koko69420/UV-Curing-Box/Schematic.pdf

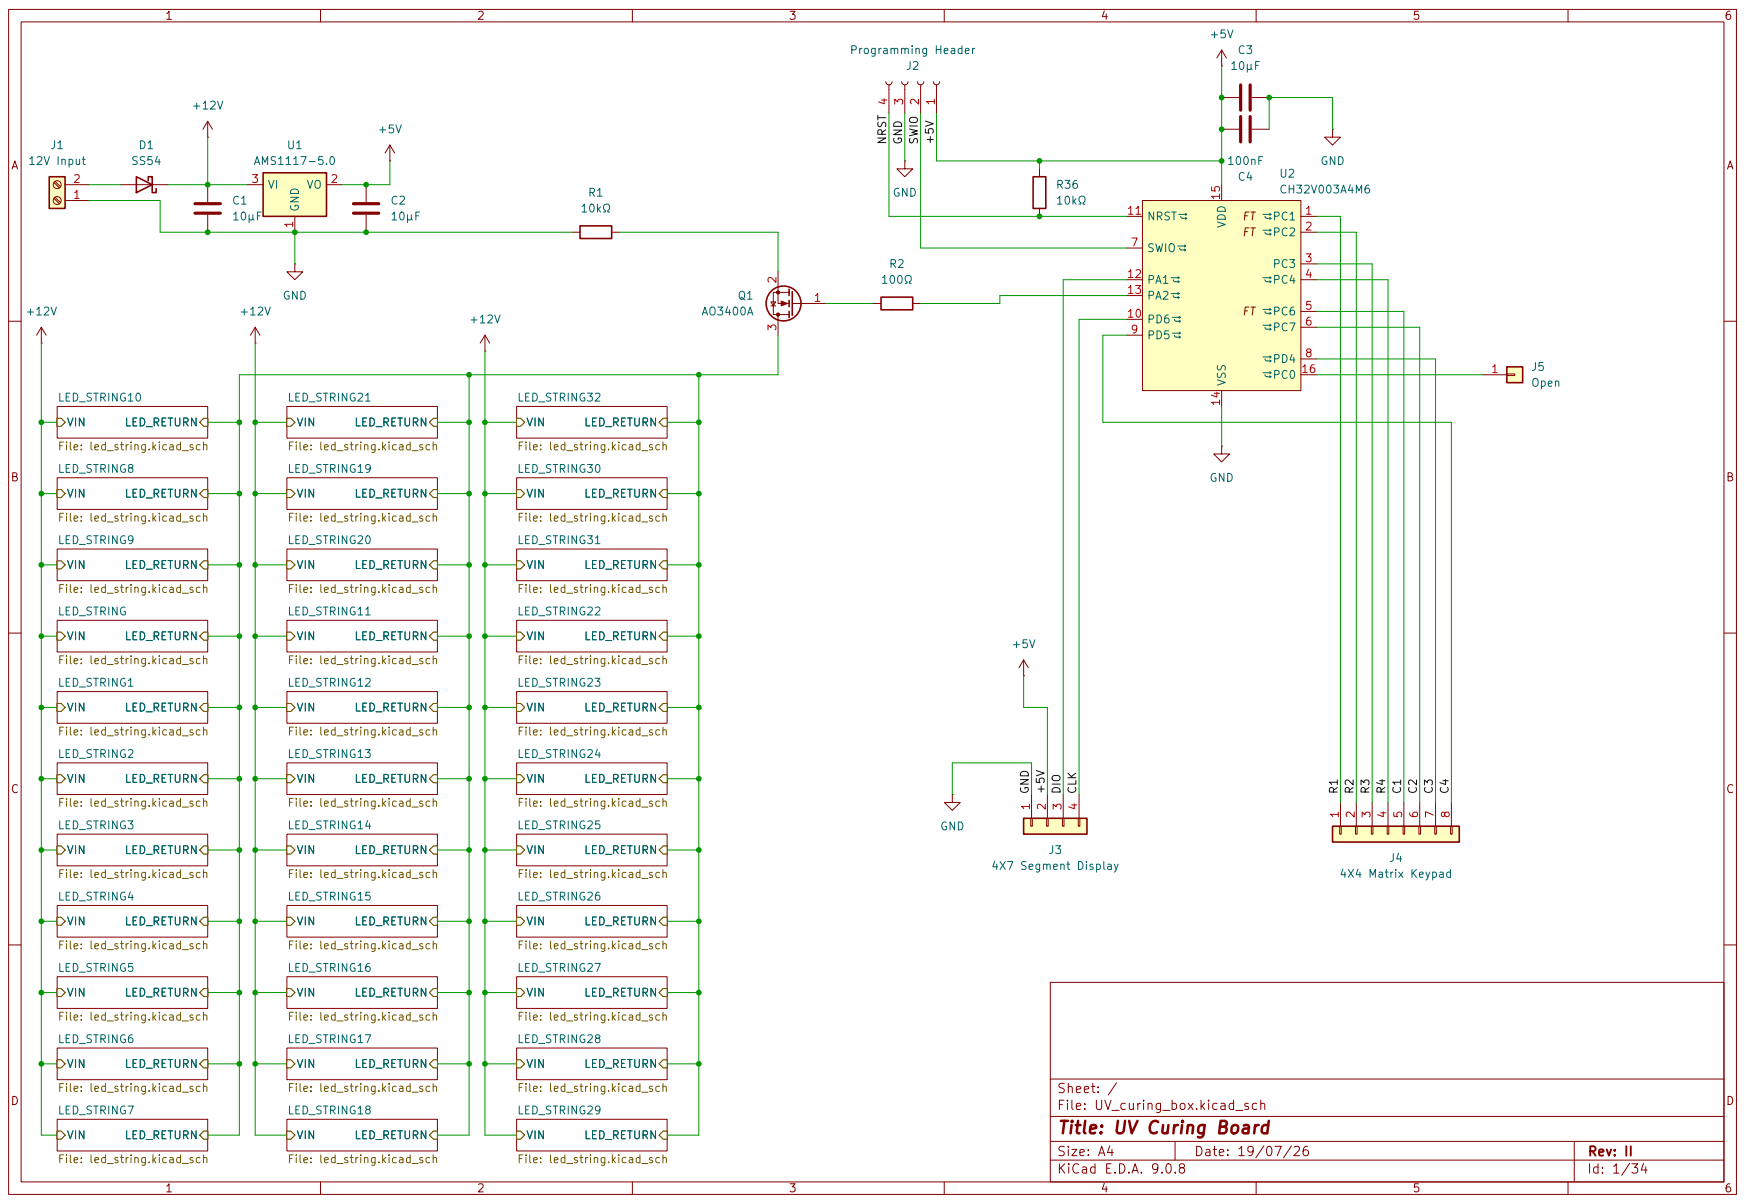
[picture p3: page 1]

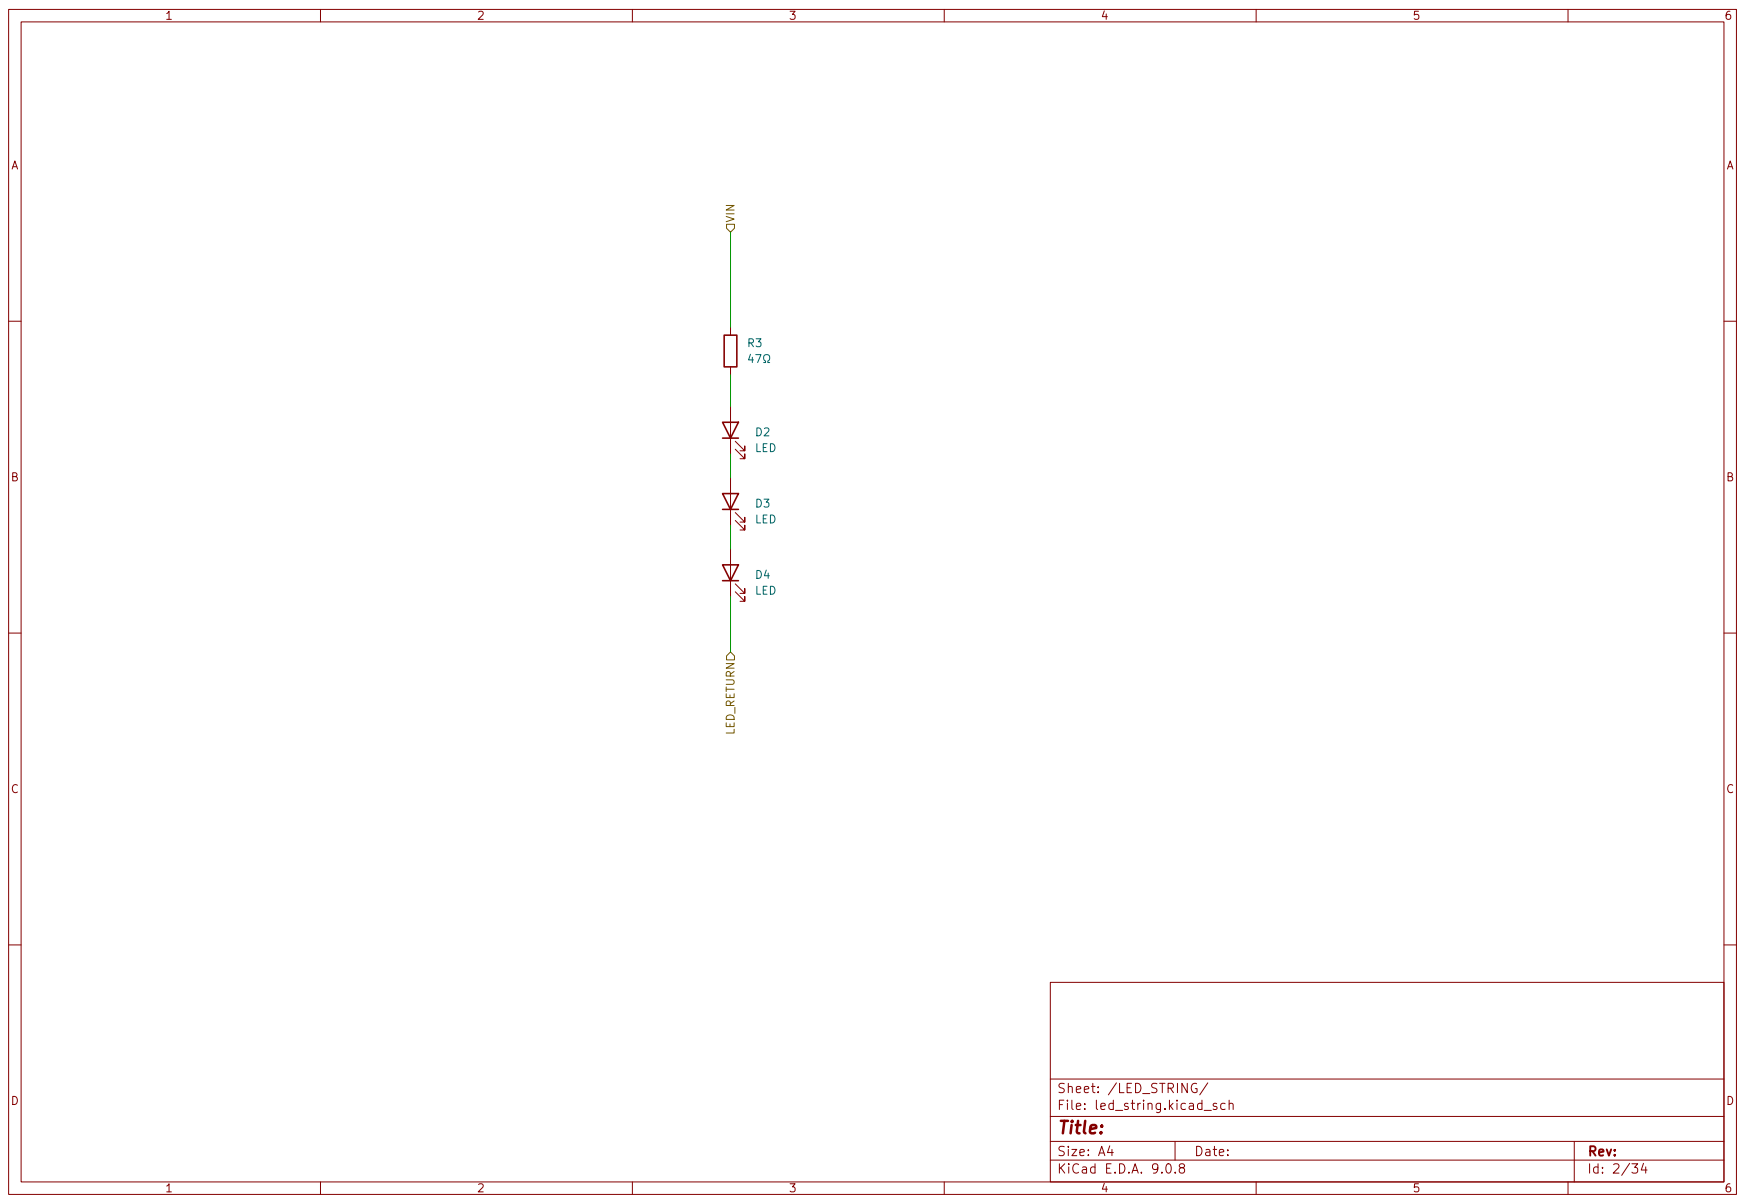
[picture p4: page 2]
