koko69420/UV-Curing-Box/UV_curing_box-B_Cu.pdf

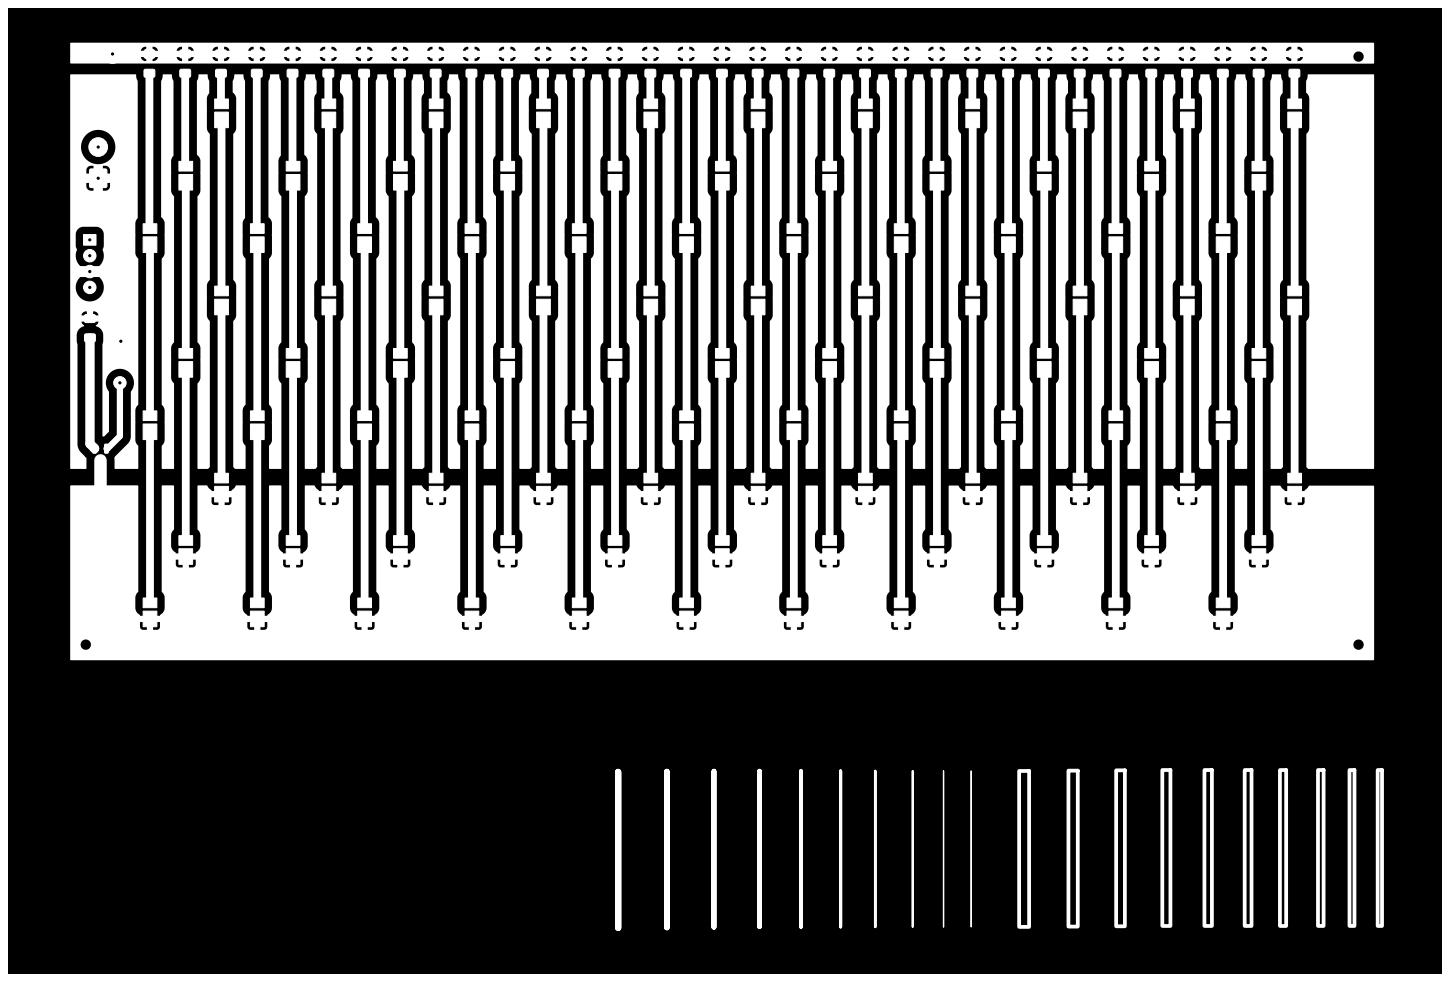
[picture p5: page 1]
