koko69420/UV-Curing-Box/UV_curing_box-Edge_Cuts.pdf

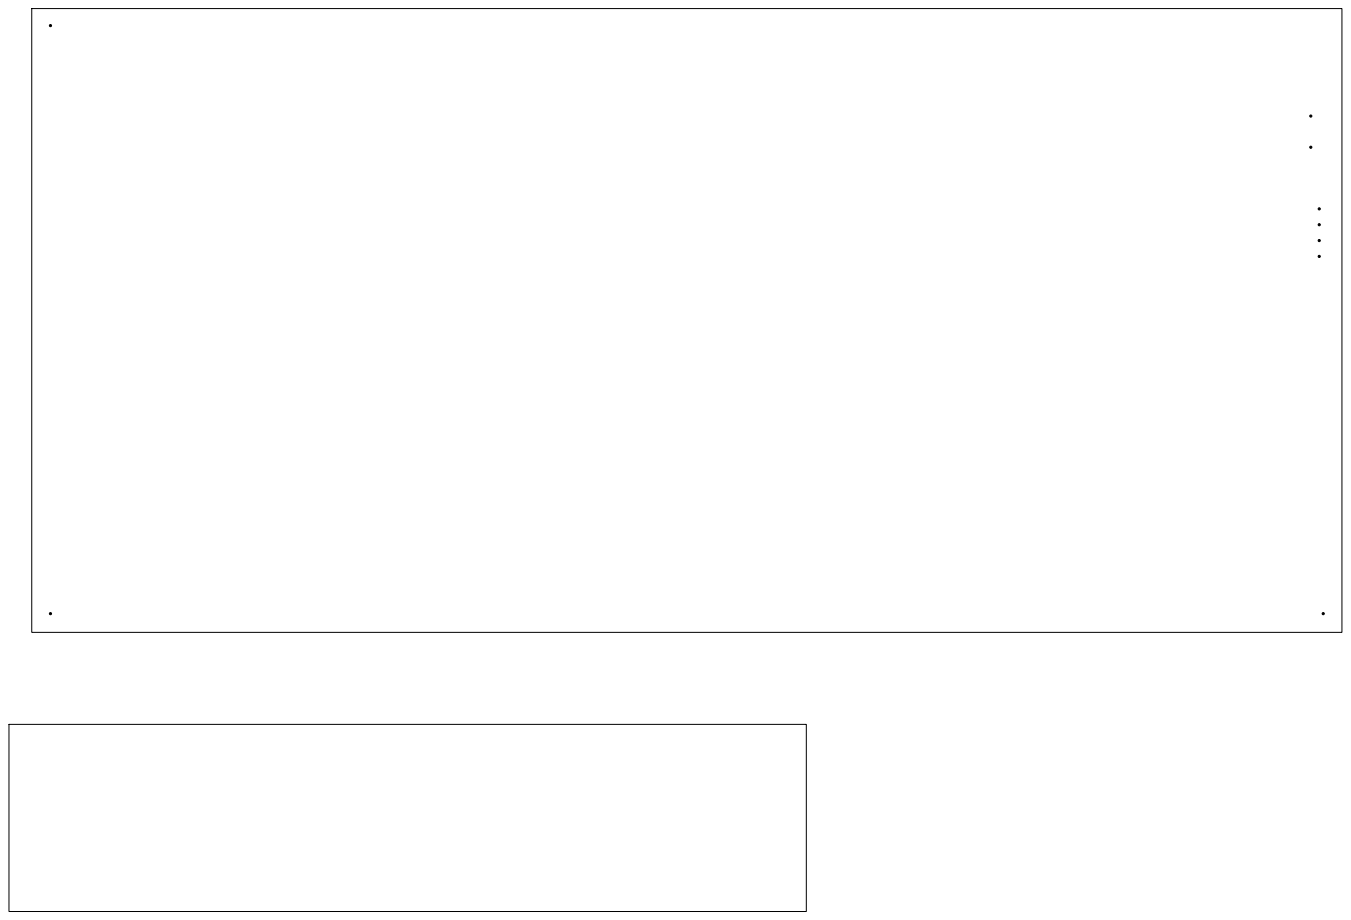
[picture p6: page 1]
