koko69420/UV-Curing-Box/UV_curing_box-F_Cu.pdf

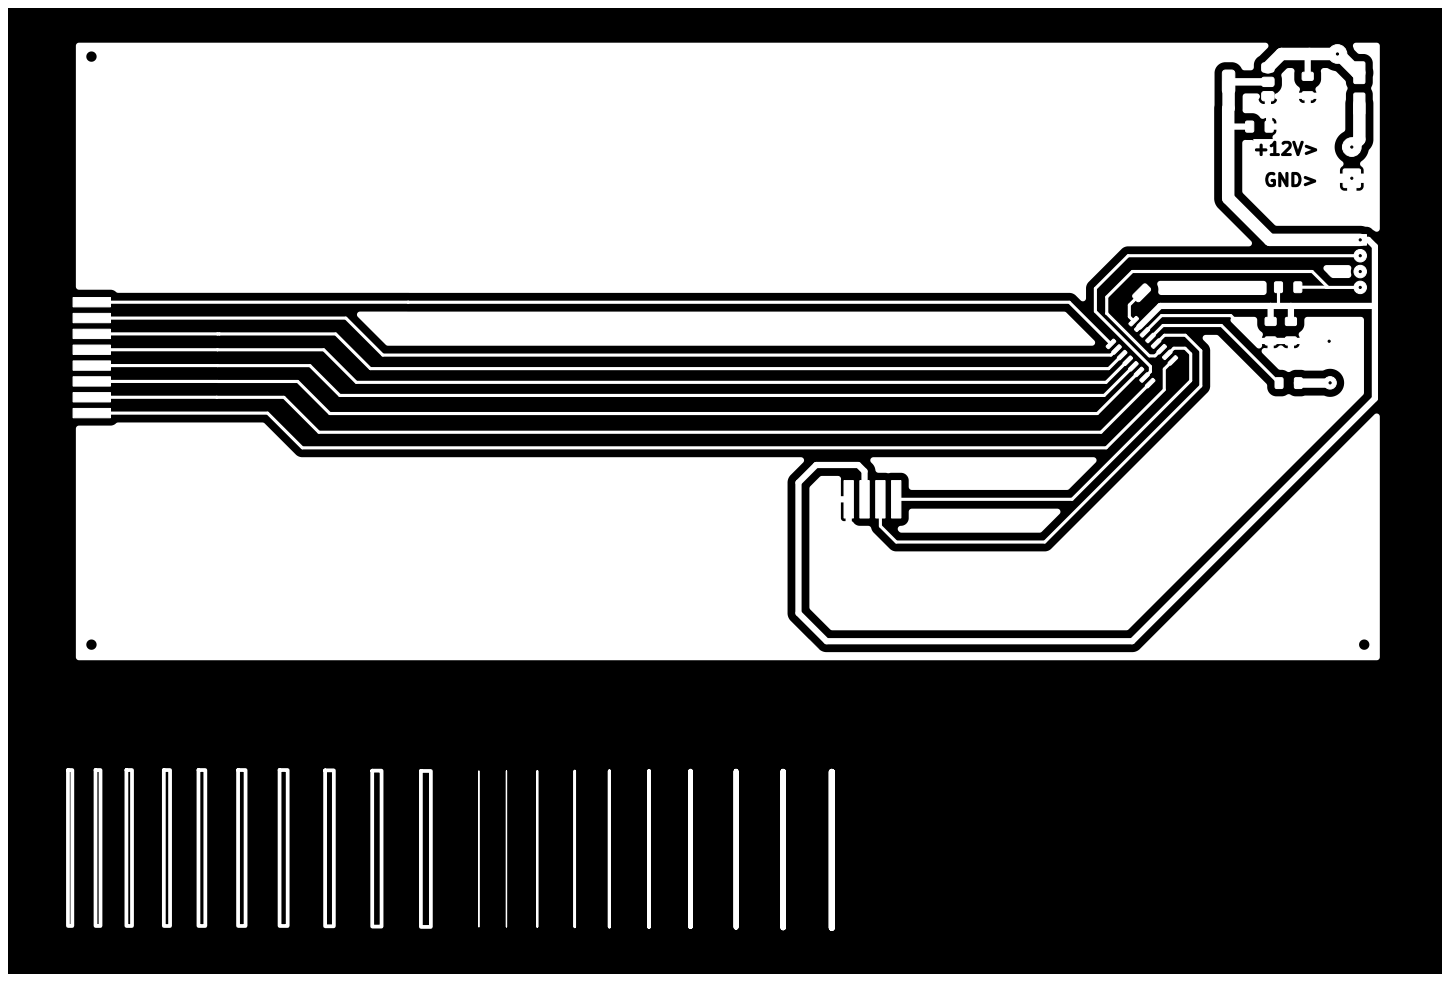
[picture p7: page 1]
