koko69420/UV-Curing-Box/UV_curing_box.kicad_pcb

## KiCad design UV_curing_box.kicad_pcb (2026-09-29)

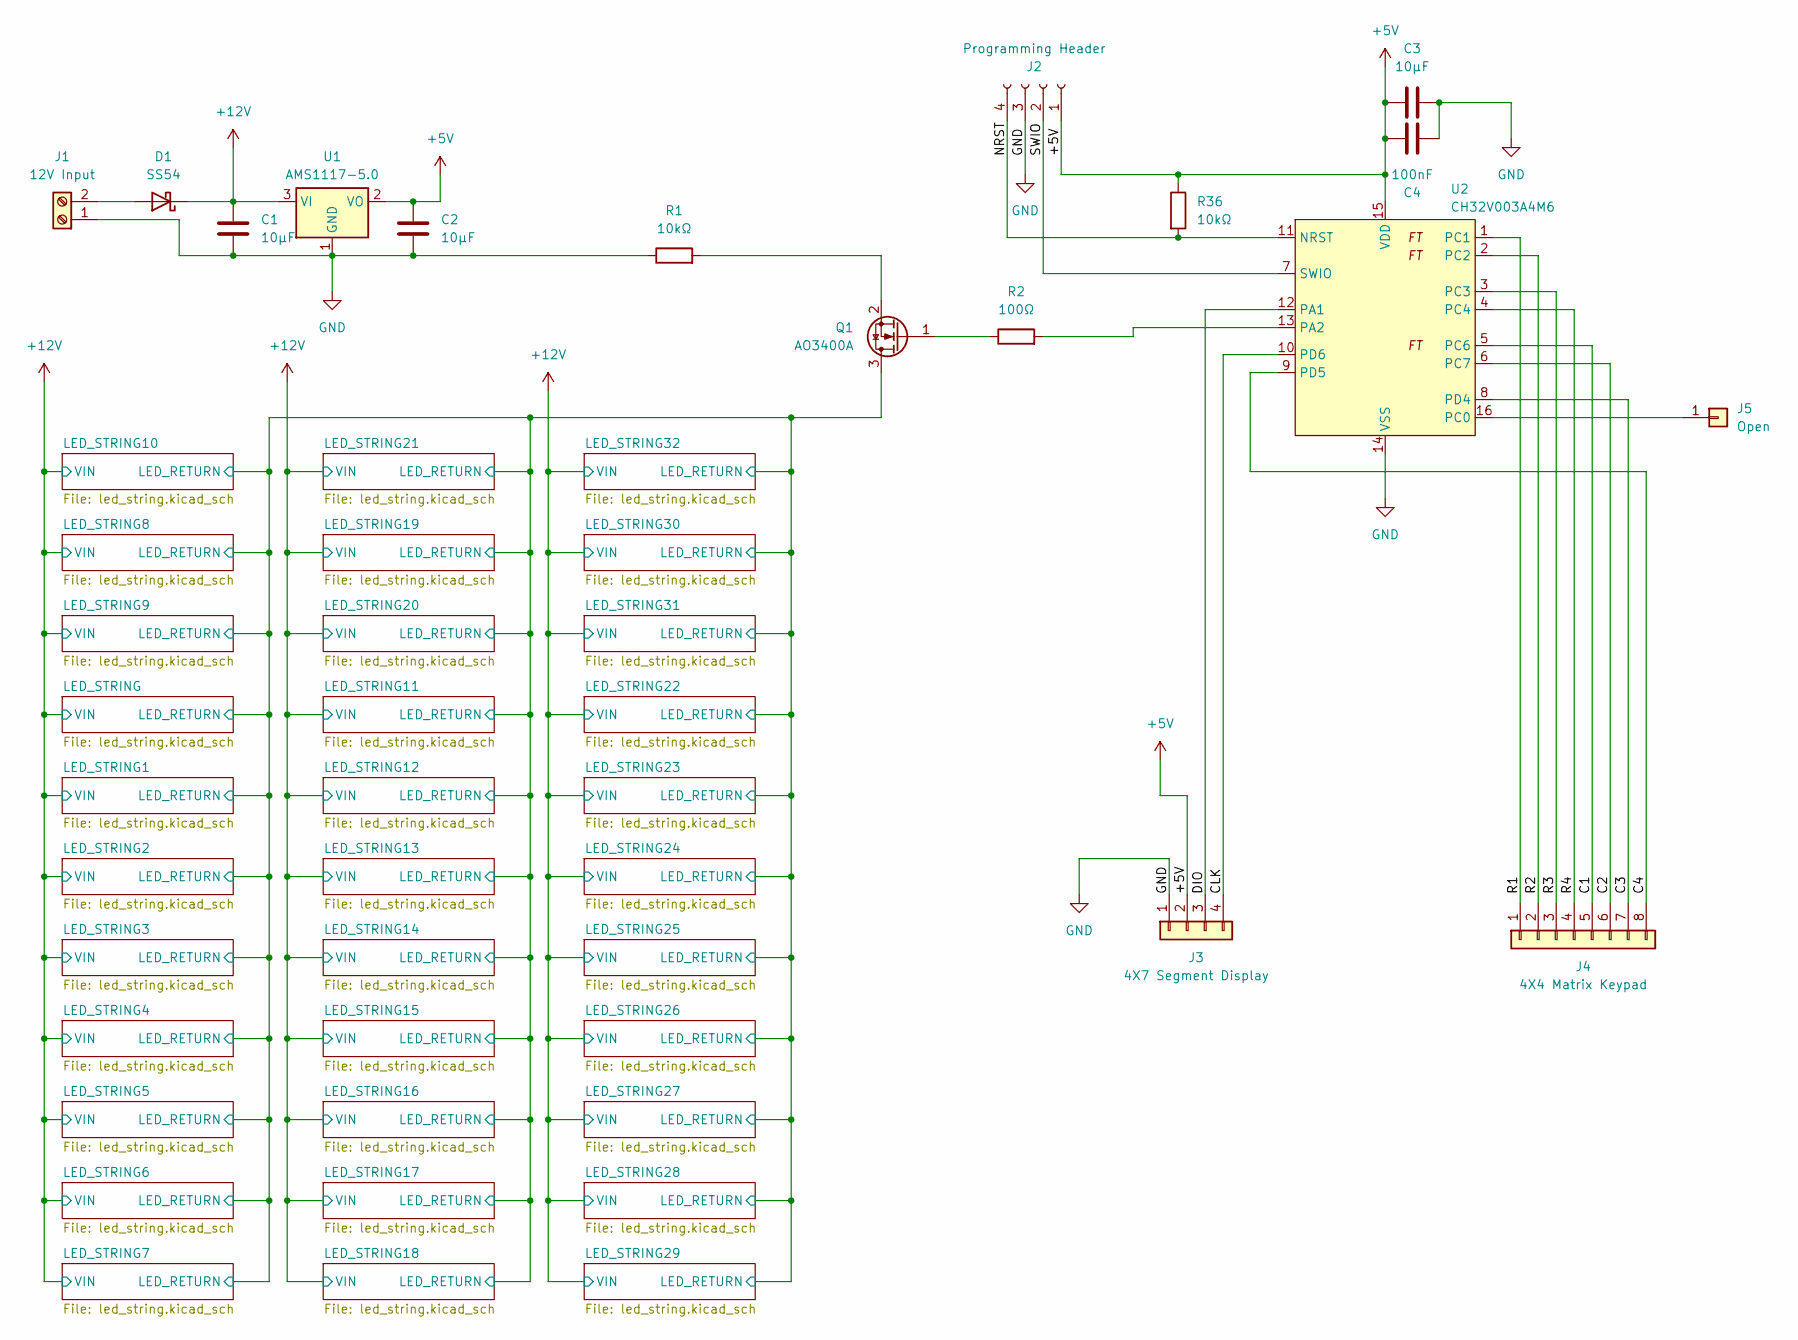
[picture p8: schematic UV_curing_box.kicad_sch, UV Curing Board]

Parts:
C1, C2, C3: 10µF; C_1206_3216Metric_Pad1.33x1.80mm_HandSolder
C4: 100nF; C_1206_3216Metric_Pad1.33x1.80mm_HandSolder
D1: SS54; D_SMA_Handsoldering
J1: 12V Input; TerminalBlock_MaiXu_MX126-5.0-02P_1x02_P5.00mm
J2: Programming Header; PinSocket_1x04_P2.54mm_Vertical
J3: 4X7 Segment Display; smd_conn_1x04_2.54
J4: 4X4 Matrix Keypad; smd_conn_1x08_2.54
J5: Open; SolderWirePad_1x01_SMD_1.5x3mm
Q1: AO3400A; SOT-23
R1, R36: 10kΩ; R_1206_3216Metric_Pad1.30x1.75mm_HandSolder
R2: 100Ω; R_1206_3216Metric_Pad1.30x1.75mm_HandSolder
U1: AMS1117-5.0; SOT-223-3_TabPin2
U2: CH32V003A4M6; SO-16_3.9x9.9mm_P1.27mm

Connections:
+5V: C2.1, C3.1, C4.1, J2.1, J3.2, R36.1, U1.2 (VO), U2.15 (VDD)
+12V: C1.1, D1.1 (K), U1.3 (VI); also elsewhere on the board
/C1: J4.5, U2.5 (PC6)
/C2: J4.6, U2.6 (PC7)
/C3: J4.7, U2.8 (PD4)
/C4: J4.8, U2.9 (UART_TX)
/CLK: J3.4, U2.10 (UART_RX)
/DIO: J3.3, U2.12 (OSCI)
/LED_STRING/LED_RETURN: Q1.3 (D); also elsewhere on the board
/NRST: J2.4, R36.2, U2.11 (NRST)
/R1: J4.1, U2.1 (PC1)
/R2: J4.2, U2.2 (PC2)
/R3: J4.3, U2.3 (PC3)
/R4: J4.4, U2.4 (PC4)
/SWIO: J2.2, U2.7 (SWIO)
GND: C1.2, C2.2, C3.2, C4.2, J1.1, J2.3, J3.1, R1.1, U1.1 (GND), U2.14 (VSS)
unnamed: D1.2 (A), J1.2
unnamed: J5.1, U2.16 (PC0)
unnamed: Q1.1 (G), R2.1
unnamed: Q1.2 (S), R1.2
unnamed: R2.2, U2.13 (OSCO)

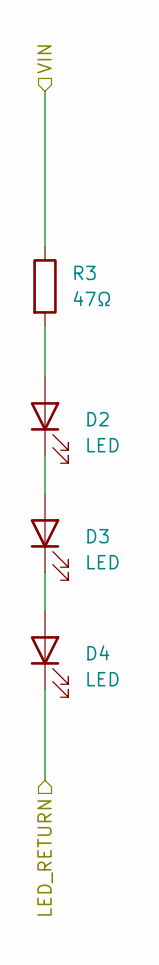
[picture p9: schematic led_string.kicad_sch]

Parts:
D2, D3, D4: LED; LED_PLCC_2835_Handsoldering
R3: 47Ω; R_1206_3216Metric_Pad1.30x1.75mm_HandSolder

Connections:
+12V: R3.1; also elsewhere on the board
/LED_STRING/LED_RETURN: D4.1 (K); also elsewhere on the board
unnamed: D2.2 (A), R3.2
unnamed: D2.1 (K), D3.2 (A)
unnamed: D3.1 (K), D4.2 (A)

Parts of its further copies:
D5, D6, D7, D8, D9, D10, D11, D12, D13, D14, D15, D16, D17, D18, D19, D20, D21, D22, D23, D24, D25, D26, D27, D28, D29, D30, D31, D32, D33, D34, D35, D36, D37, D38, D39, D40, D41, D42, D43, D44, D45, D46, D47, D48, D49, D50, D51, D52, D53, D54, D55, D56, D57, D58, D59, D60, D61, D62, D63, D64, D65, D66, D67, D68, D69, D70, D71, D72, D73, D74, D75, D76, D77, D78, D79, D80, D81, D82, D83, D84, D85, D86, D87, D88, D89, D90, D91, D92, D93, D94, D95, D96, D97, D98, D99, D100: LED; LED_PLCC_2835_Handsoldering
R4, R5, R6, R7, R8, R9, R10, R11, R12, R13, R14, R15, R16, R17, R18, R19, R20, R21, R22, R23, R24, R25, R26, R27, R28, R29, R30, R31, R32, R33, R34, R35: 47Ω; R_1206_3216Metric_Pad1.30x1.75mm_HandSolder

Connections of its further copies:
+12V: R4.1, R5.1, R6.1, R7.1, R8.1, R9.1, R10.1, R11.1, R12.1, R13.1, R14.1, R15.1, R16.1, R17.1, R18.1, R19.1, R20.1, R21.1, R22.1, R23.1, R24.1, R25.1, R26.1, R27.1, R28.1, R29.1, R30.1, R31.1, R32.1, R33.1, R34.1, R35.1; also elsewhere on the board
/LED_STRING/LED_RETURN: D7.1 (K), D10.1 (K), D13.1 (K), D16.1 (K), D19.1 (K), D22.1 (K), D25.1 (K), D28.1 (K), D31.1 (K), D34.1 (K), D37.1 (K), D40.1 (K), D43.1 (K), D46.1 (K), D49.1 (K), D52.1 (K), D55.1 (K), D58.1 (K), D61.1 (K), D64.1 (K), D67.1 (K), D70.1 (K), D73.1 (K), D76.1 (K), D79.1 (K), D82.1 (K), D85.1 (K), D88.1 (K), D91.1 (K), D94.1 (K), D97.1 (K), D100.1 (K); also elsewhere on the board
unnamed: D5.2 (A), R4.2
unnamed: D5.1 (K), D6.2 (A)
unnamed: D6.1 (K), D7.2 (A)
unnamed: D8.2 (A), R5.2
unnamed: D8.1 (K), D9.2 (A)
unnamed: D9.1 (K), D10.2 (A)
unnamed: D11.2 (A), R6.2
unnamed: D11.1 (K), D12.2 (A)
unnamed: D12.1 (K), D13.2 (A)
unnamed: D14.2 (A), R7.2
unnamed: D14.1 (K), D15.2 (A)
unnamed: D15.1 (K), D16.2 (A)
unnamed: D17.2 (A), R8.2
unnamed: D17.1 (K), D18.2 (A)
unnamed: D18.1 (K), D19.2 (A)
unnamed: D20.2 (A), R9.2
unnamed: D20.1 (K), D21.2 (A)
unnamed: D21.1 (K), D22.2 (A)
unnamed: D23.2 (A), R10.2
unnamed: D23.1 (K), D24.2 (A)
unnamed: D24.1 (K), D25.2 (A)
unnamed: D26.2 (A), R11.2
unnamed: D26.1 (K), D27.2 (A)
unnamed: D27.1 (K), D28.2 (A)
unnamed: D29.2 (A), R12.2
unnamed: D29.1 (K), D30.2 (A)
unnamed: D30.1 (K), D31.2 (A)
unnamed: D32.2 (A), R13.2
unnamed: D32.1 (K), D33.2 (A)
unnamed: D33.1 (K), D34.2 (A)
unnamed: D35.2 (A), R14.2
unnamed: D35.1 (K), D36.2 (A)
unnamed: D36.1 (K), D37.2 (A)
unnamed: D38.2 (A), R15.2
unnamed: D38.1 (K), D39.2 (A)
unnamed: D39.1 (K), D40.2 (A)
unnamed: D41.2 (A), R16.2
unnamed: D41.1 (K), D42.2 (A)
unnamed: D42.1 (K), D43.2 (A)
unnamed: D44.2 (A), R17.2
unnamed: D44.1 (K), D45.2 (A)
unnamed: D45.1 (K), D46.2 (A)
unnamed: D47.2 (A), R18.2
unnamed: D47.1 (K), D48.2 (A)
unnamed: D48.1 (K), D49.2 (A)
unnamed: D50.2 (A), R19.2
unnamed: D50.1 (K), D51.2 (A)
unnamed: D51.1 (K), D52.2 (A)
unnamed: D53.2 (A), R20.2
unnamed: D53.1 (K), D54.2 (A)
unnamed: D54.1 (K), D55.2 (A)
unnamed: D56.2 (A), R21.2
unnamed: D56.1 (K), D57.2 (A)
unnamed: D57.1 (K), D58.2 (A)
unnamed: D59.2 (A), R22.2
unnamed: D59.1 (K), D60.2 (A)
unnamed: D60.1 (K), D61.2 (A)
unnamed: D62.2 (A), R23.2
unnamed: D62.1 (K), D63.2 (A)
unnamed: D63.1 (K), D64.2 (A)
unnamed: D65.2 (A), R24.2
unnamed: D65.1 (K), D66.2 (A)
unnamed: D66.1 (K), D67.2 (A)
unnamed: D68.2 (A), R25.2
unnamed: D68.1 (K), D69.2 (A)
unnamed: D69.1 (K), D70.2 (A)
unnamed: D71.2 (A), R26.2
unnamed: D71.1 (K), D72.2 (A)
unnamed: D72.1 (K), D73.2 (A)
unnamed: D74.2 (A), R27.2
unnamed: D74.1 (K), D75.2 (A)
unnamed: D75.1 (K), D76.2 (A)
unnamed: D77.2 (A), R28.2
unnamed: D77.1 (K), D78.2 (A)
unnamed: D78.1 (K), D79.2 (A)
unnamed: D80.2 (A), R29.2
unnamed: D80.1 (K), D81.2 (A)
unnamed: D81.1 (K), D82.2 (A)
unnamed: D83.2 (A), R30.2
unnamed: D83.1 (K), D84.2 (A)
unnamed: D84.1 (K), D85.2 (A)
unnamed: D86.2 (A), R31.2
unnamed: D86.1 (K), D87.2 (A)
unnamed: D87.1 (K), D88.2 (A)
unnamed: D89.2 (A), R32.2
unnamed: D89.1 (K), D90.2 (A)
unnamed: D90.1 (K), D91.2 (A)
unnamed: D92.2 (A), R33.2
unnamed: D92.1 (K), D93.2 (A)
unnamed: D93.1 (K), D94.2 (A)
unnamed: D95.2 (A), R34.2
unnamed: D95.1 (K), D96.2 (A)
unnamed: D96.1 (K), D97.2 (A)
unnamed: D98.2 (A), R35.2
unnamed: D98.1 (K), D99.2 (A)
unnamed: D99.1 (K), D100.2 (A)

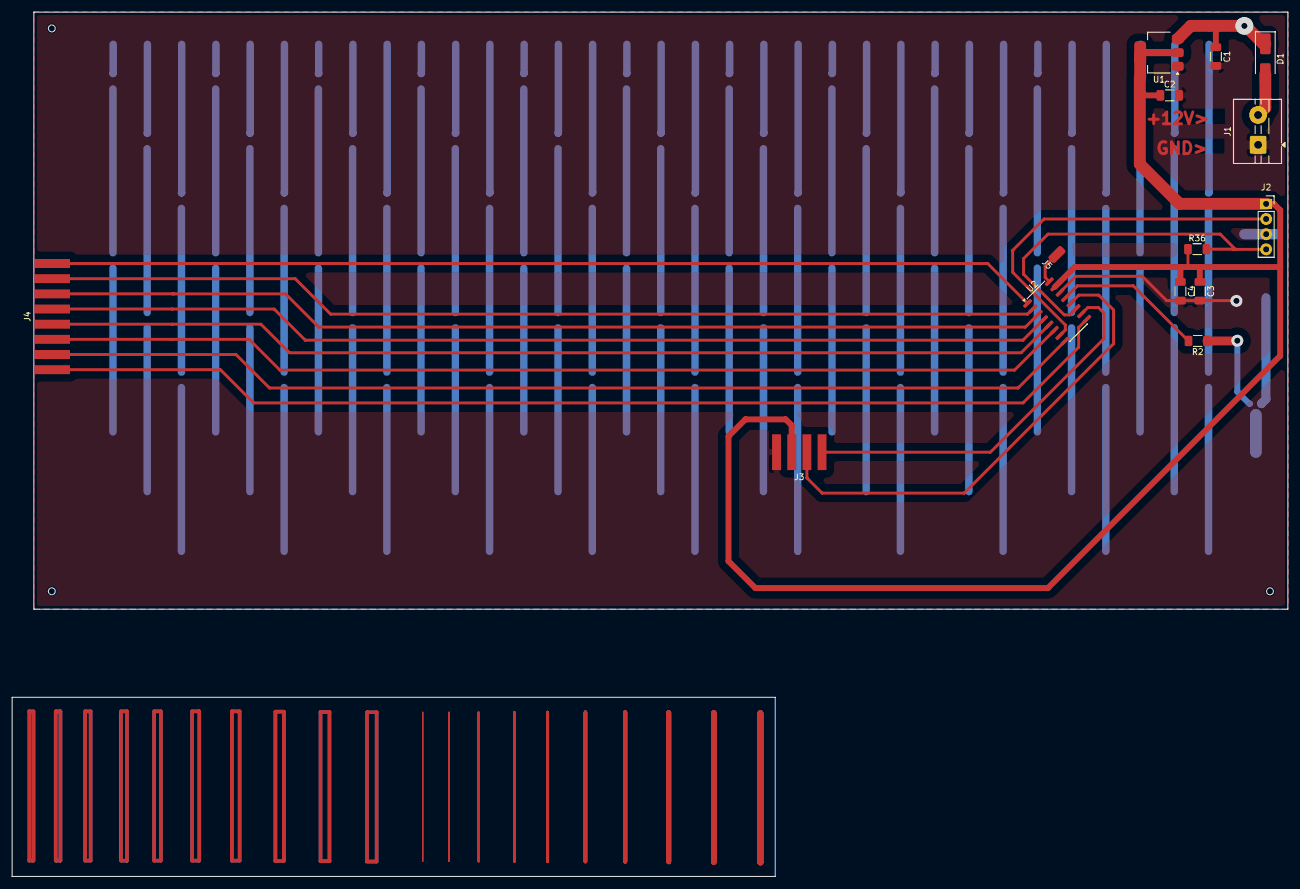
[picture p10: board UV_curing_box.kicad_pcb from above]

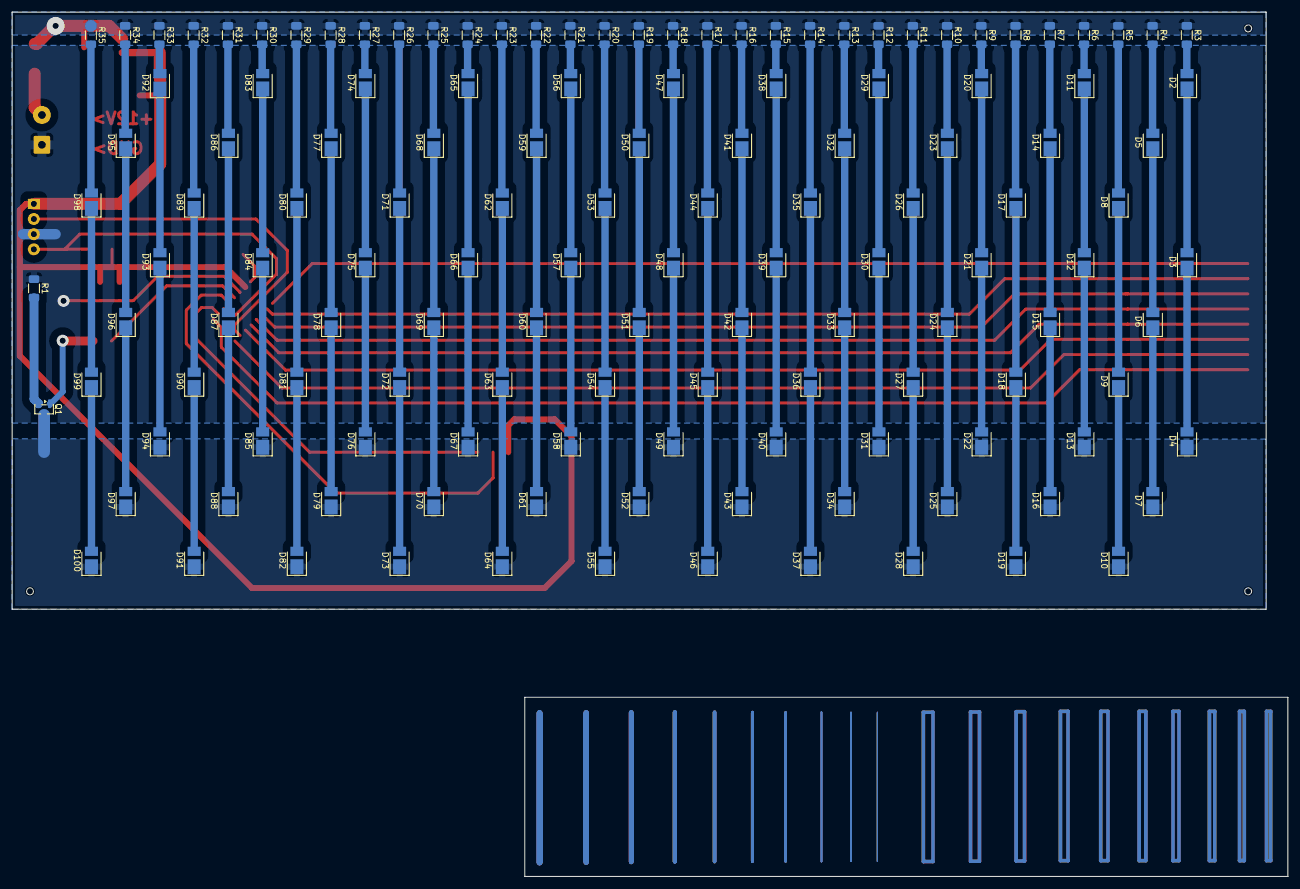
[picture p11: board UV_curing_box.kicad_pcb from below]

Board: 2 copper layers, 210.0 x 100.0 mm, 148 parts (134 on the bottom side), 120 nets.
