koko69420/UV-Curing-Box/(commit log)

2026-09-29 Initial commit of UV Curing Box firmware and KiCad hardware
    [UV_curing_box.kicad_pcb, UV_curing_box.kicad_sch, led_string.kicad_sch]
2026-09-29 Update README: Embed physical prototype display photo, KiCad schematic, and PCB SVG layers
